14Point7/SLC-Free/README.md

SLC-Free
========

SLC Free is the only open source Wideband O2 Controller that works and is worth a damn
