14Point7/SLC-Free/SLC_Free_Eagle_Layout_PCB_Files/SLC_Free_PCB.brd

## EAGLE design SLC_Free_Eagle_Layout_PCB_Files/SLC_Free_PCB.brd (2013-12-18)

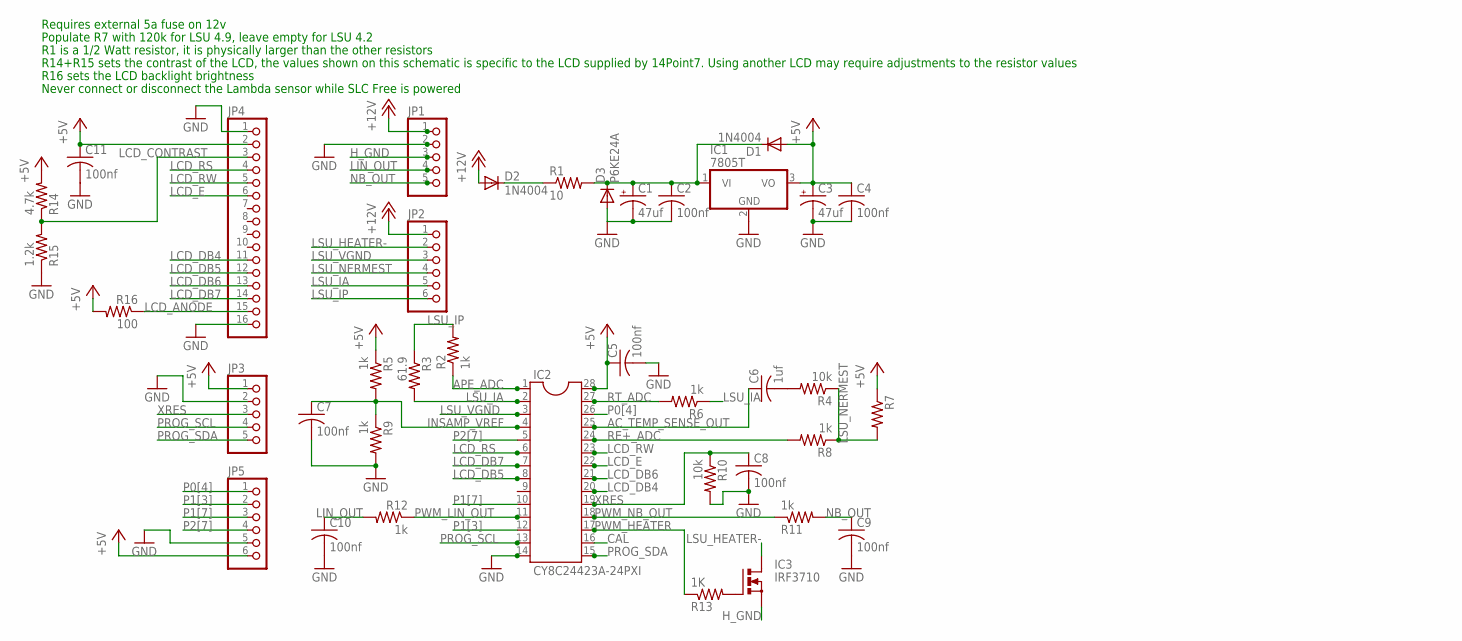
[picture p1: schematic SLC_Free_PCB.sch]

Parts:
C1, C3: 47uf; E2-5
C2, C4, C5, C7, C8, C9, C10, C11: 100nf; C025-025X050
C6: 1uf; C025-025X050
D1, D2: 1N4004; DO41-10
D3: P6KE24A; DO41-10
IC1: 7805T; TO220H
IC2: CY8C24423A-24PXI; DIL28-3
IC3: IRF3710; TO220BH
JP1, JP3: PINHD-1X5; 1X05
JP2, JP5: PINHD-1X6; 1X06
JP4: PINHD-1X16; 1X16
R1: 10; 0309/12
R2, R5, R6, R8, R9, R11, R12: 1k; 0204/7
R3: 61.9; 0204/7
R4, R10: 10k; 0204/7
R7: R-US_0204/7; 0204/7
R13: 1K; 0204/7
R14: 4.7k; 0204/7
R15: 1.2k; 0204/7
R16: 100; 0204/7

Connections:
+5V: C3.+, C4.1, C5.1, C11.1, D1.A, IC1.3 (VO), IC2.28, JP3.1, JP4.2, JP5.6, R5.1, R7.1, R14.2, R16.2
+12V: D2.A, JP1.1, JP2.1
AC_TEMP_SENSE_OUT: C6.1, IC2.25
APE_ADC: IC2.1, R2.1
CAL: IC2.16
GND: C1.-, C2.2, C3.-, C4.2, C5.2, C7.2, C8.2, C9.2, C10.2, C11.2, D3.A, IC1.2 (GND), IC2.14, JP1.2, JP3.2, JP4.1, JP4.16, JP5.5, R9.2, R10.2, R15.1
H_GND: IC3.S, JP1.3
INSAMP_VREF: C7.1, IC2.4, R5.2, R9.1
LCD_ANODE: JP4.15, R16.1
LCD_CONTRAST: JP4.3, R14.1, R15.2
LCD_DB4: IC2.20, JP4.11
LCD_DB5: IC2.8, JP4.12
LCD_DB6: IC2.21, JP4.13
LCD_DB7: IC2.7, JP4.14
LCD_E: IC2.22, JP4.6
LCD_RS: IC2.6, JP4.4
LCD_RW: IC2.23, JP4.5
LIN_OUT: C10.1, JP1.4, R12.2
LSU_HEATER-: IC3.D, JP2.2
LSU_IA: IC2.2, JP2.5, R3.2, R6.1
LSU_IP: JP2.6, R2.2, R3.1
LSU_NERMEST: JP2.4, R4.1, R7.2, R8.1
LSU_VGND: IC2.3, JP2.3
unnamed: C6.2, R4.2
unnamed: C1.+, C2.1, D1.C, D3.C, IC1.1 (VI), R1.2
unnamed: IC3.G, R13.2
unnamed: D2.C, R1.1
NB_OUT: C9.1, JP1.5, R11.2
P0[4]: IC2.26, JP5.1
P1[3]: IC2.12, JP5.2
P1[7]: IC2.10, JP5.3
P2[7]: IC2.5, JP5.4
PROG_SCL: IC2.13, JP3.4
PROG_SDA: IC2.15, JP3.5
PWM_HEATER: IC2.17, R13.1
PWM_LIN_OUT: IC2.11, R12.1
PWM_NB_OUT: IC2.18, R11.1
RE+_ADC: IC2.24, R8.2
RT_ADC: IC2.27, R6.2
XRES: C8.1, IC2.19, JP3.3, R10.1

Notes on the sheet:
Requires external 5a fuse on 12v
Populate R7 with 120k for LSU 4.9, leave empty for LSU 4.2
R16 sets the LCD backlight brightness
R1 is a 1/2 Watt resistor, it is physically larger than the other resistors
R14+R15 sets the contrast of the LCD, the values shown on this schematic is specific to the LCD supplied by 14Point7. Using another LCD may require adjustments to the resistor values
Never connect or disconnect the Lambda sensor while SLC Free is powered

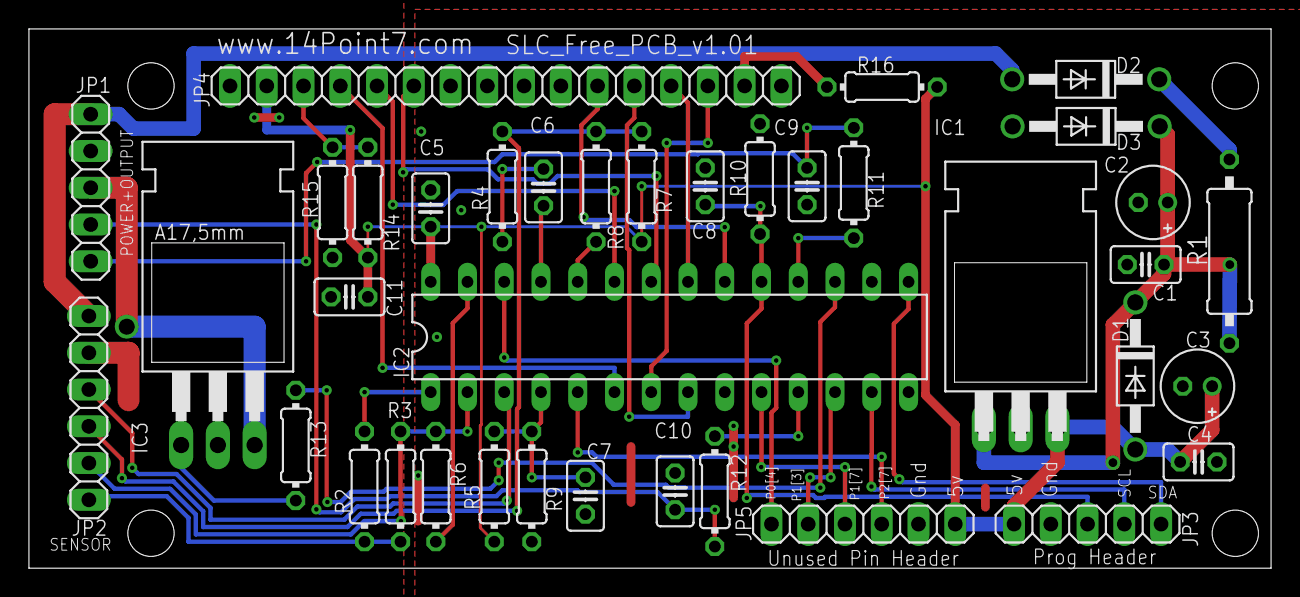
[picture p2: board SLC_Free_PCB.brd from above]

Board: 2 copper layers, 85.8 x 37.3 mm, 38 parts (0 on the bottom side), 39 nets.
